alexduta192/Wearable-Sleep-Monitoring-System-/Duta_Alexandru-Vlad-ppt.v4.pptx

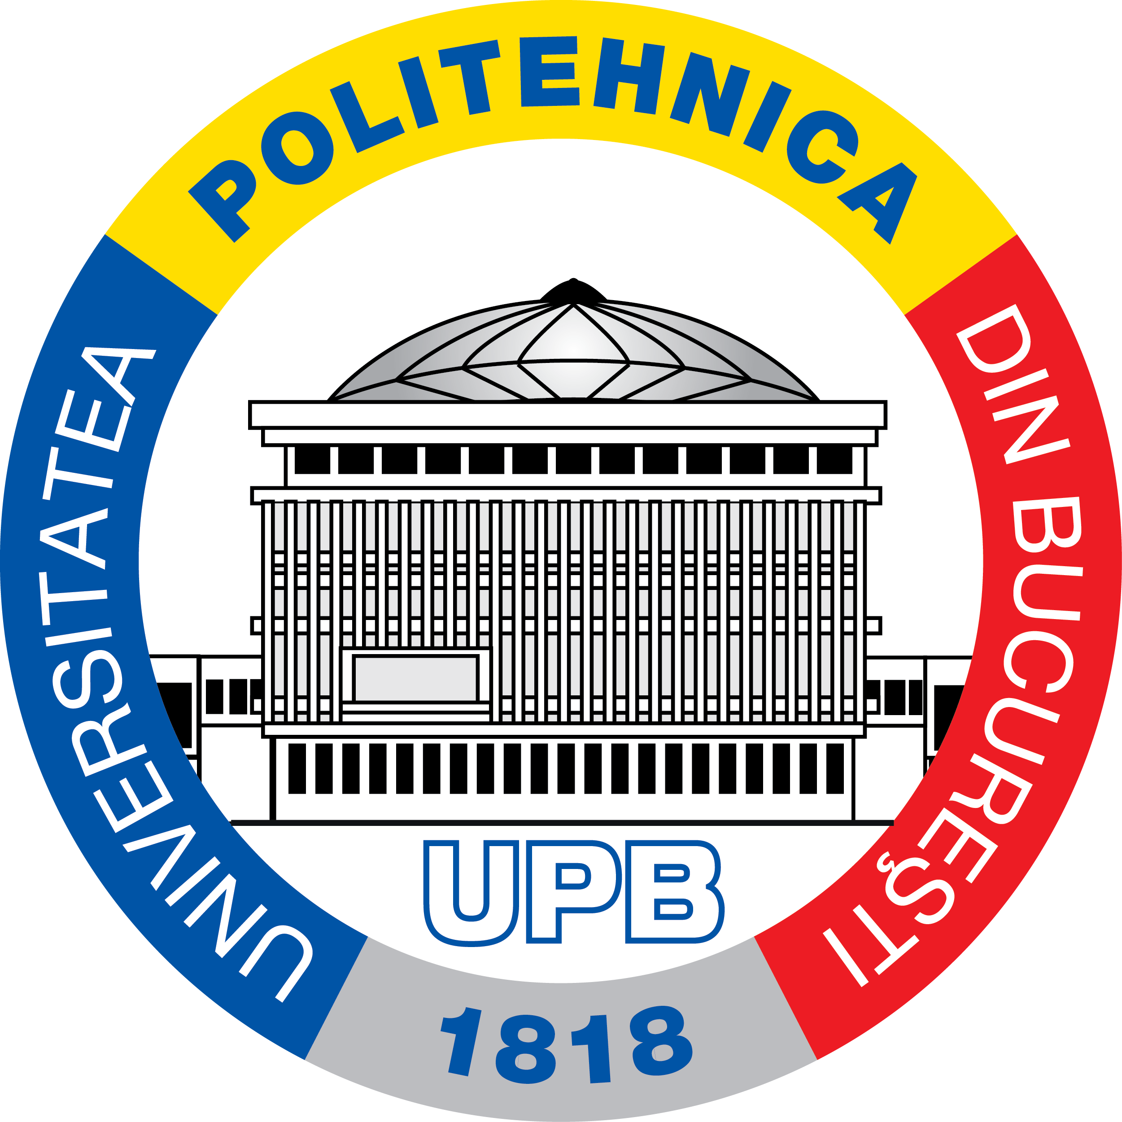
[picture p1: figure]
UPB Logo

NATIONAL UNIVERSITY OF SCIENCE AND TECHNOLOGY POLITEHNICA BUCHAREST

Developing a System for Physiological Signal Acquisition and Analysis for Sleep Quality Assessment

DIPLOMA PROJECT

GRADUATE

Duta Alexandru-Vlad

SCIENTIFIC COORDINATOR

Ph.D. Ovidiu Grigore

Faculty of Electronics, Telecommunications and Information Technology ·
2026

## Slide 2

00

Presentation Structure

Introduction to Sleep

Sleep stages, cycles, and why monitoring matters

1

Motivation

PSG vs commercial wearables vs this project

2

System Architecture & Hardware

ESP32-C3, sensors, wearable integration

Data Acquisition & Dashboard

Firmware, server, SQLite storage, live monitoring

3

4

Signal Processing & Features

Filtering, 21 features per 30-second window

5

Sleep Stage Classification

K-Means clustering, physiological rules, KNN

6

Results & Validation

10 sessions, hypnograms, quality scores

Conclusions & Future Work

Achievements, limitations, next steps

7

8

Overview

02 / 17

## Slide 3

01

Introduction to Sleep

Sleep occupies roughly one third of human life and is essential for physical recovery, memory consolidation, and emotional regulation. The AASM classifies sleep into four stages based on brain, muscle, and eye activity.

Light Transition

Theta waves replace alpha. Transition from wakefulness. Easy to wake.

→ System: Light Sleep

Not distinguished from N2 without EEG

Deep / SWS

Delta waves dominate. Lowest heart rate. Peak growth hormone and immune activity.

→ System: Deep Sleep

BPM≤P40 & motion≤P50, capped 25%

Rapid Eye Movement

Dreaming occurs. Muscle tone suppressed. Emotional and procedural memory processing.

→ System: REM Sleep

BPM≥P65 & std≥P55, capped 30%

N1

5–10%

Light Sleep

Sleep spindles and K-complexes. Heart rate falls. Memory consolidation begins.

→ System: Light Sleep

Not distinguished from N2 without EEG

N2

45–55%

N3

20–25%

REM

20–25%

This system outputs 4 classes — Wake/Movement, Light Sleep (N1+N2 combined), Deep Sleep, REM — since wrist sensors without EEG cannot separate N1 from N2.

A typical night contains 4–6 cycles of ~90 minutes each. N3 dominates early cycles; REM periods lengthen toward morning.

Introduction to Sleep

03 / 17

## Slide 4

02

Motivation

€600 – 2 000

per night

Clinical PSG

Gold standard but expensive, lab-bound, requires trained staff

65 – 75%

accuracy

Commercial Wearables

Affordable but black-box algorithms, no raw data access

Goal: build an open, low-cost wearable sleep monitoring system with full raw data access

<€100

OPEN-SOURCE

This Project

Full raw data access, 5 sensors + ML pipeline

Motivation

04 / 17

## Slide 5

03

System Architecture

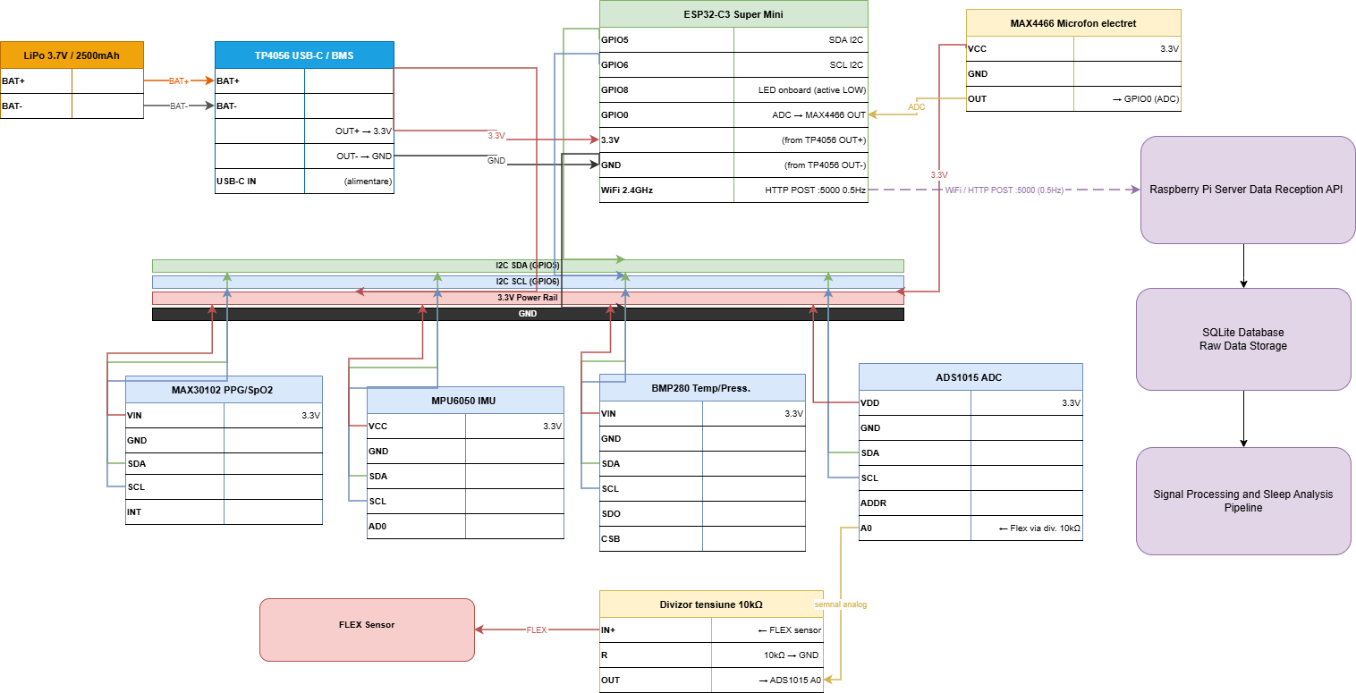
[picture p2: figure]

System Architecture & Hardware

05 / 17

## Slide 6

03

Hardware Design

ESP32-C3 Super Mini

RISC-V 160 MHz, WiFi, single-core

MCU

MAX30102

PPG + SpO₂ (red 660nm, IR 880nm)

Optical

MPU6050

6-axis IMU (accel + gyro)

Motion

BMP280

Skin temperature (±0.5°C)

Temperature

ADS1015 + Flex

Respiration via chest band

Respiration

MAX4466

Microphone for snoring detection

Acoustic

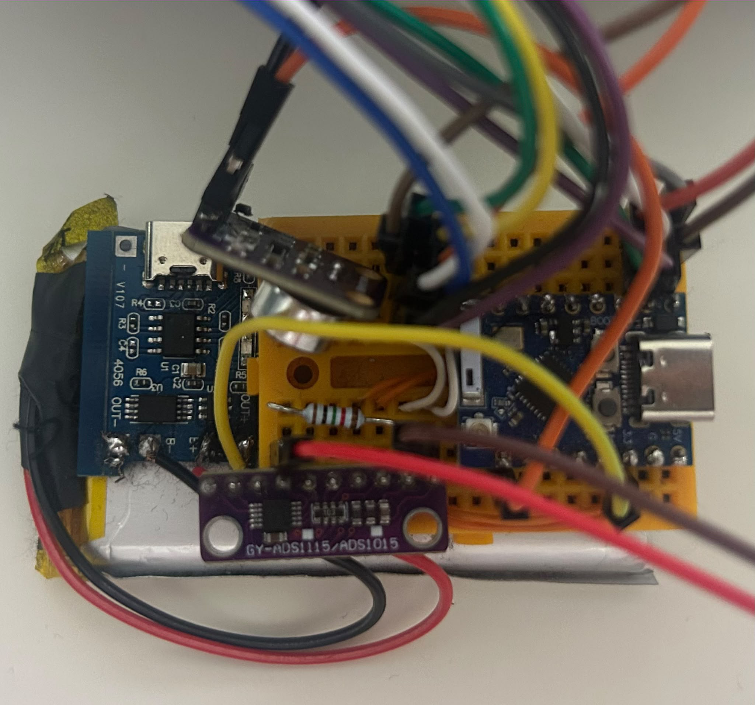
[picture p3: figure]

TP4056 + LiPo 2500 mAh · >17h runtime

System Architecture & Hardware

06 / 17

## Slide 7

03

Wearable Integration

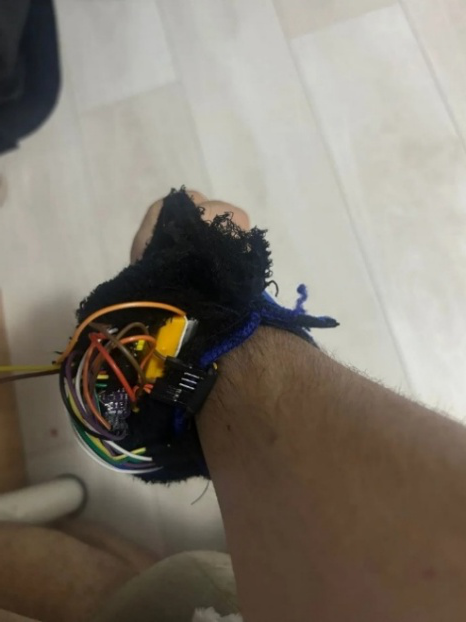
[picture p4: figure]
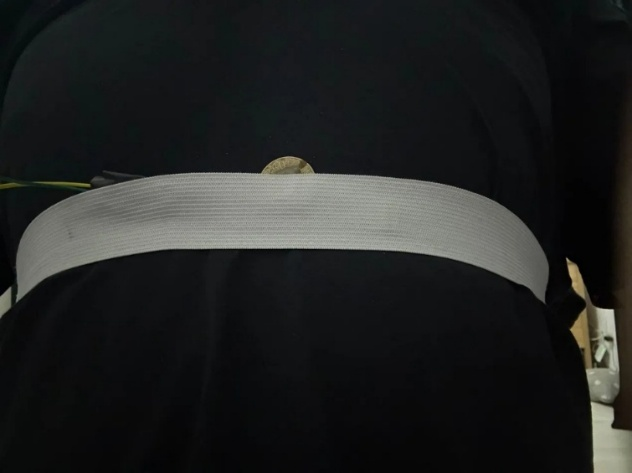
[picture p5: figure]

Wrist Unit

Elastic Chest Band

Flex sensor for respiration monitoring

PPG, IMU, temperature, microphone sensors during recording

System Architecture & Hardware

07 / 17

## Slide 8

04

Data Acquisition

Sensor Reading

PPG (IR+Red)

IMU (Acc+Gyro)

Flex (Resp.)

Temperature

Microphone

JSON Assembly

Single combined HTTP POST every 2s (single-core constraint)

{ "t":"23:35:01",
"ir":54231,
"red":48120,
"ax":0.01,
"ay":-0.99,"az":0.03,
"fr":612,"fd":-8,
"tmp":35.3,
"ppg_ir":"54231,...",
"mic_s":"1066,..." }

SQLite Storage

Raspberry Pi stores all raw data in structured tables

Analysis Pipeline

21 features/window. K-Means+KNN. Quality score.

Step A

Signal filtering
(sensor-specific)

Step B

Feature extraction
(21 features)

Step C

K-Means clustering
(k=4)

Step D

KNN + smoothing
+ scoring

1

2

3

4

12.5 Hz

10 Hz

raw_data

timestamp, JSON

4 Hz

→

→

ppg_data

IR, Red, BPM

→

1 Hz

flex_data

ADC, resp. rate

200 Hz

mic_data

RMS amplitude

WiFi

HTTP POST :5000
to Raspberry Pi

Key design decision: single combined POST per cycle avoids sample loss on single-core ESP32-C3

~227

Data Acquisition & Dashboard

samples/sec across
all sensors

2s

POST interval
single-core ESP32

6–10h

recording duration
per session

08 / 17

## Slide 9

04

Live Dashboard

Real-time signal monitoring on port 8080 during active recording sessions

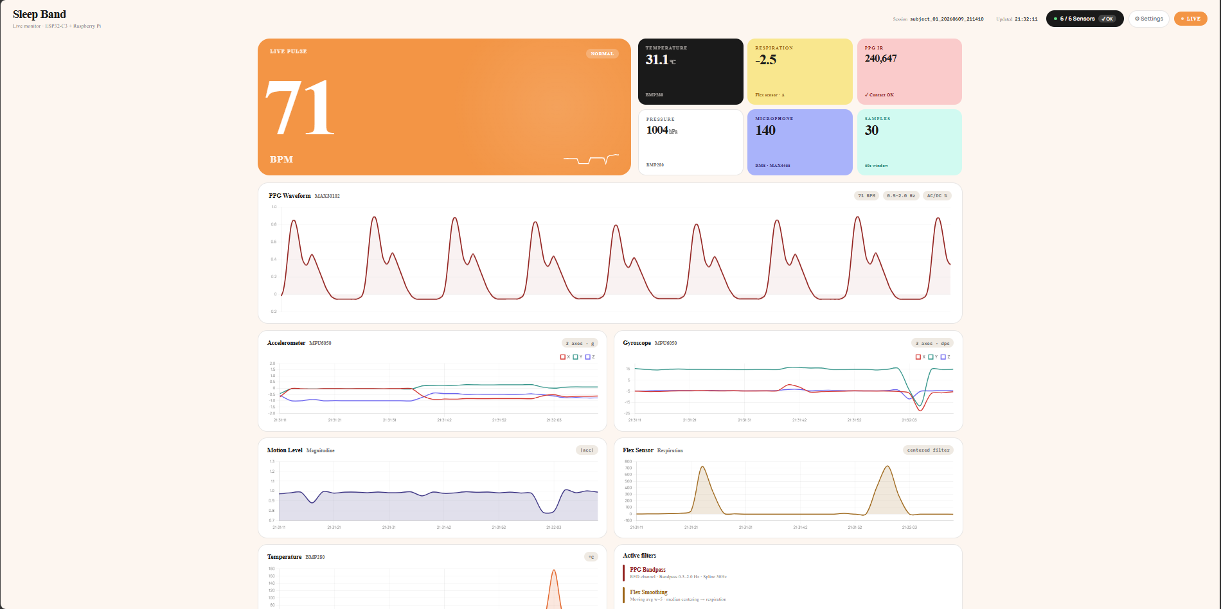
[picture p6: figure]

Data Acquisition & Dashboard

09 / 17

## Slide 10

05

PPG (IR)

Signal Processing

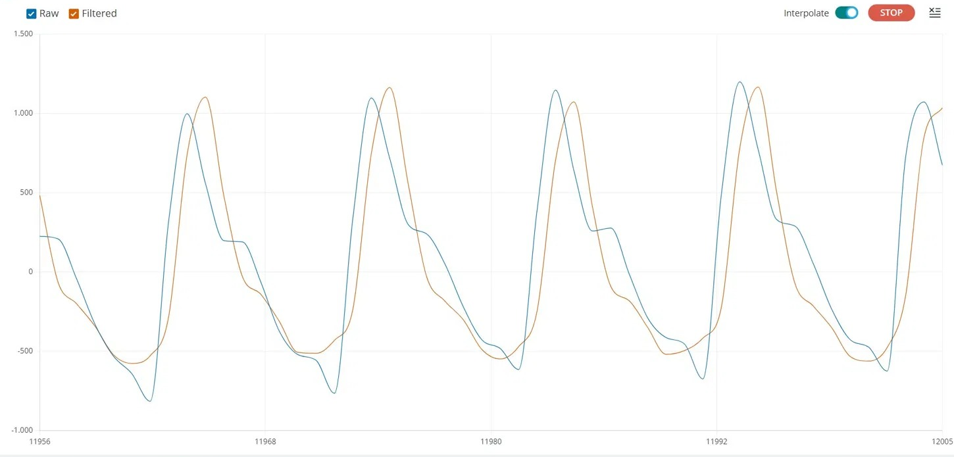
[picture p7: figure]

Butterworth 0.5–3.5 Hz, order 3

Gyroscope

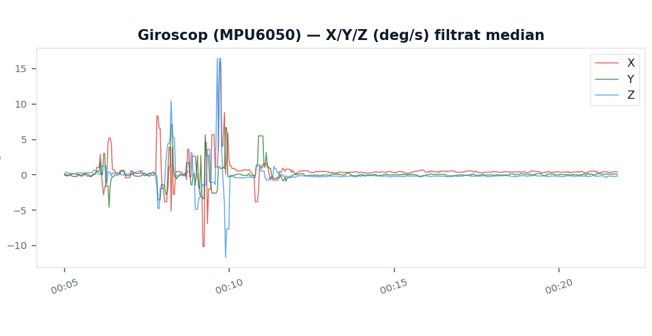
[picture p8: figure]

Median filter, kernel size 5

PPG chart

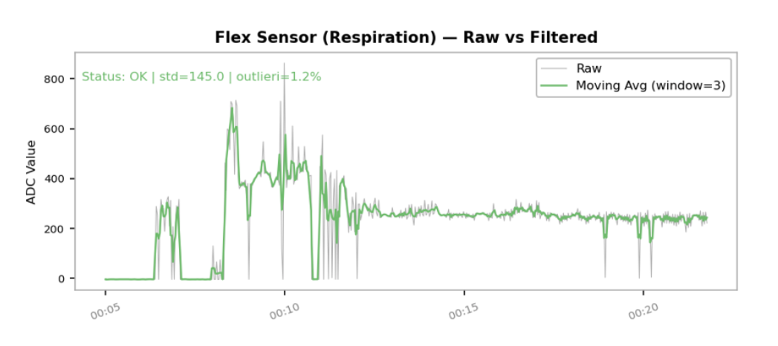
[picture p9: figure]

Flex Sensor

Moving average, window 3

Butterworth lowpass 0.1 Hz, order 3

Temperature

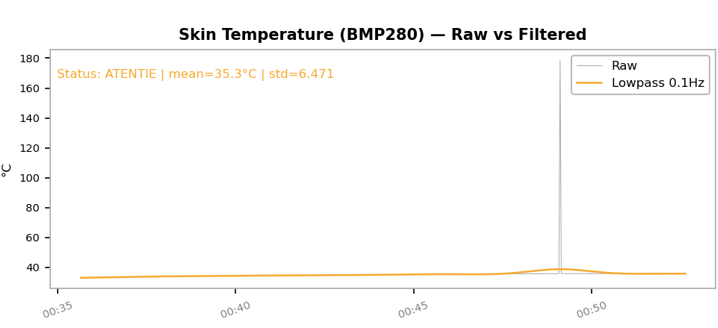
[picture p10: figure]

Signal Processing & Features

10 / 17

## Slide 11

Feature Extraction

21 features per 30-second window · StandardScaler · weighted by physiological relevance

05

PPG / Cardiac

×1.8

bpm_mean

×1.5

bpm_std

×1.0

bpm_min

×1.0

bpm_max

×1.6

hrv_simple

×1.2

spo2_est

Motion

×2.5

motion_level

×2.2

acc_jerk

×2.0

gyro_energy

×0.5

motion_variation

×1.0

dominant_pos

Respiration

×1.8

resp_rate

×1.4

resp_variability

×1.2

resp_amplitude

×1.0

apnea_flag

Temperature

×0.8

temp_mean

×0.5

temp_variation

Acoustic

score only

snore_events_count

score only

snore_intensity

Raw features → StandardScaler (zero mean, unit variance) → Multiply by weights → K-Means input.

Signal Processing & Features

Preprocessing Pipeline

contact_valid_ratio excluded (data leakage risk)

11 / 17

## Slide 12

06

Sleep Stage Classification

Physiological Labeling

Wake: motion ≥ P95

REM: bpm ≥ P65 AND bpm_std ≥ P55

Deep: bpm ≤ P40 AND motion ≤ P50

Light: all remaining windows

K-Means (k=4)

Unsupervised clustering into 4 groups.

Silhouette: k=2 best (0.797)
k=4 used for clinical relevance (0.290)

1

2

KNN (k=5)

Trained on K-Means labels. Distance-weighted Euclidean in 21D. Outputs per-class probabilities.

3

Smoothing

3-epoch majority vote (90s)

Deep cap: 25%, REM cap: 30%

4

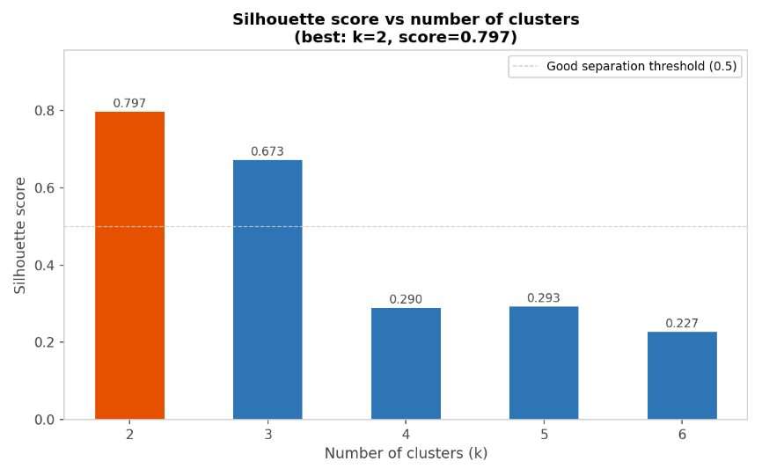
[picture p11: figure]
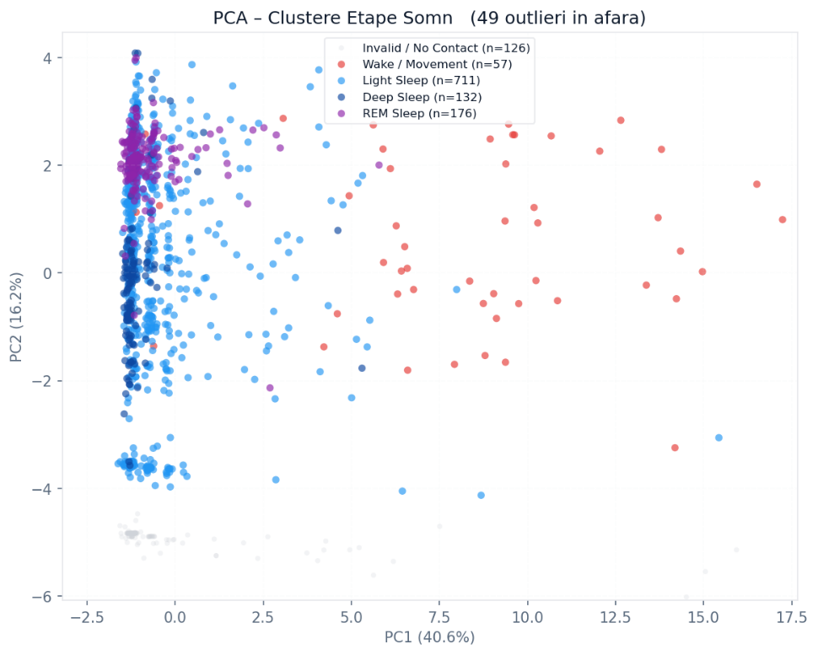
[picture p12: figure]

Sleep Stage Classification

12 / 17

## Slide 13

07

Results: Hypnogram Analysis

10 overnight sessions · 8 subjects · 375–602 min per session

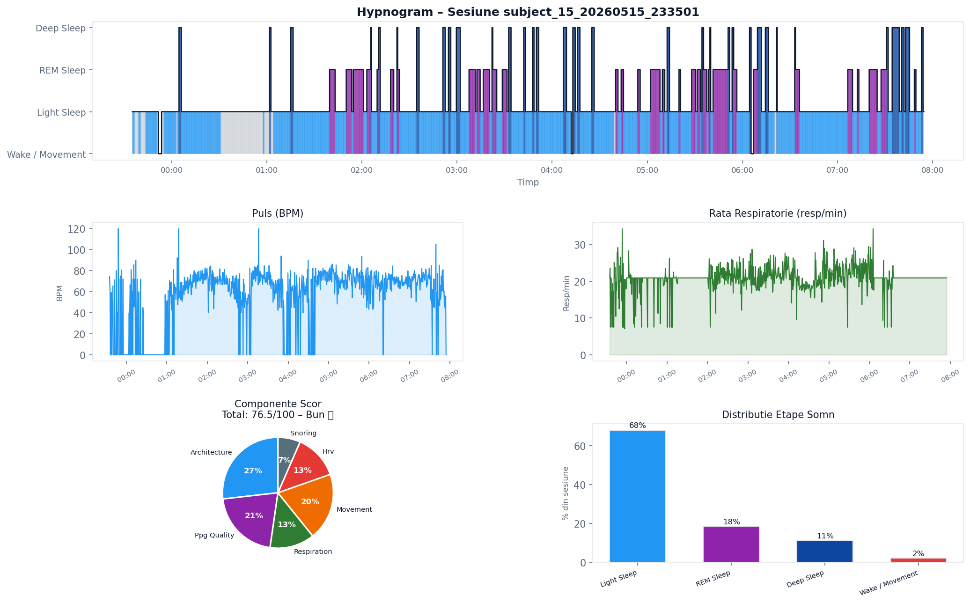
[picture p13: figure]

Results & Validation

13 / 17

## Slide 14

07

Sleep Quality Score

0–100 scale from 6 components · Duration penalty: up to −15 pts for sessions <6 hours

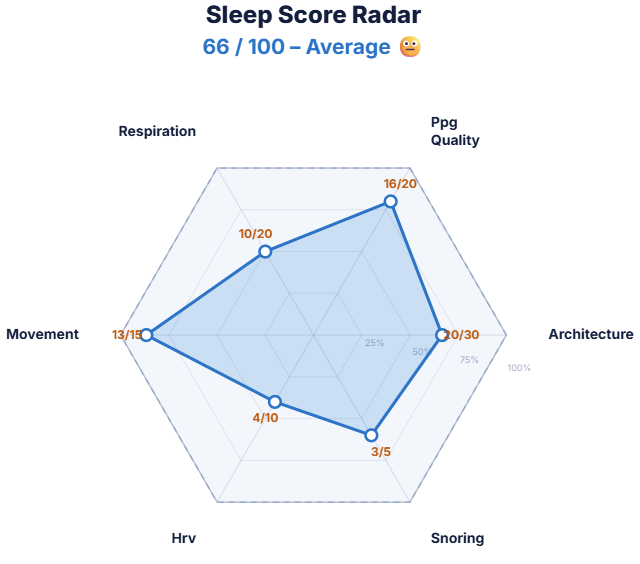
[picture p14: figure]

/30

Architecture

Deep ≥ 25%, REM ≥ 25%, Wake < 15%

/20

PPG Quality

BPM 45–70, SpO₂ ≥ 95%

/20

Respiration

RR 10–18, apnea < 2% of windows

/15

Movement

/10

HRV

Median motion < 0.05g

/5

Snoring

85–100 Excellent

70–84 Good

RMSSD 30–100 ms

0 events = full

55–69 Average

40–54 Poor

Results & Validation

14 / 17

## Slide 15

07

Subjective vs Objective Comparison

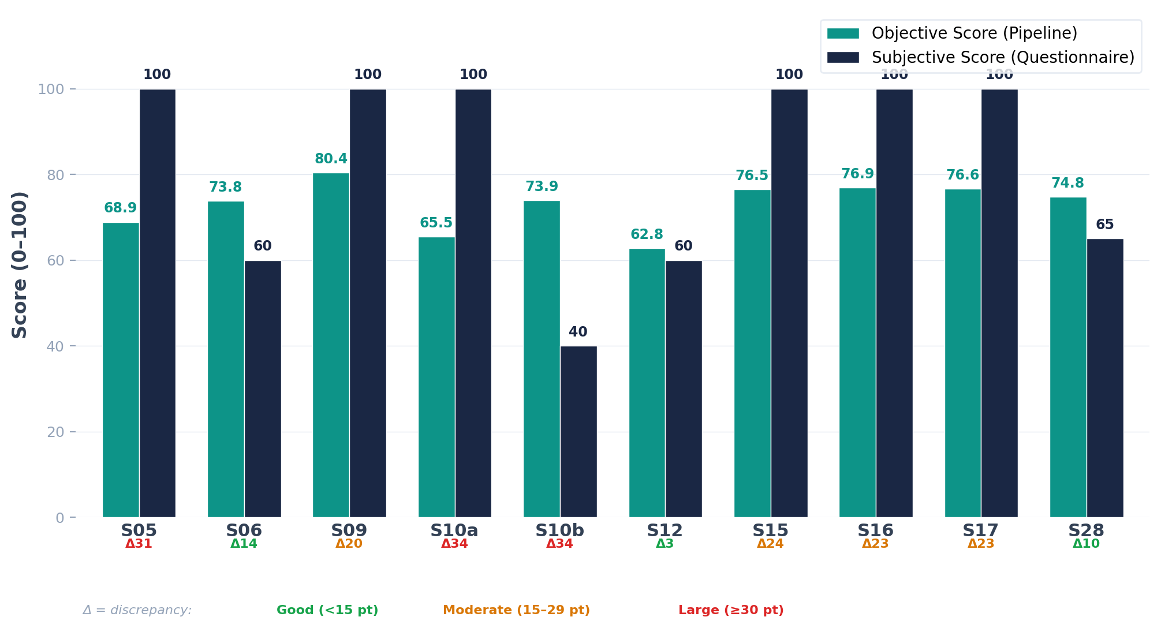
[picture p15: figure]

Results & Validation

15 / 17

## Slide 16

08

Key Findings & Limitations

Key Findings

Motion features: most reliable for sleep staging

→

Limitations

No ground truth (PSG) for epoch-level validation

—

HRV (RMSSD) + respiratory rate: strongest stage differentiation

→

Silhouette score k=4: 0.290 (overlap between stages)

—

S12 (OSA subject): 52 apnea + 257 snoring events correctly flagged

→

Single-core ESP32-C3 limits PPG to ~12.5 Hz effective

—

Subjects unaware of apnea events detected by sensors

→

Sensor displacement during sleep affects signal quality

—

Scores: 62.8 – 80.4 across valid sessions

→

Small sample: 10 sessions, 8 subjects

—

Personal contributions:
Complete hardware assembly from off-the-shelf components (<100 EUR)
ESP32-C3 firmware with multi-sensor acquisition and boot calibration
Flask/SQLite backend + real-time monitoring dashboard
Full Python pipeline: signal processing, 21-feature extraction, K-Means + KNN classification, sleep quality scoring
10 overnight recording sessions with 8 subjects + questionnaire validation

→

→

→

→

→

Key Findings & Limitations

16 / 17

## Slide 17

08

Conclusions & Future Work

The system demonstrates that open-source, low-cost sleep monitoring with full raw data access is achievable with current off-the-shelf components.

FUTURE WORK

Continuous 25 Hz PPG for frequency-domain HRV

01

Dual-core MCU

Custom 3D-printed enclosure for stable sensor contact

02

Rigid Housing

Inductive/impedance-based instead of flex sensor

Simultaneous recording for ground truth benchmarking

03

Better Respiratory Sensor

KNN evaluated on held-out data for real accuracy

04

Cross-session Training

05

PSG Validation

Thank you!

Conclusions & Future Work

17 / 17

## Slide 18

References

[3] R. B. Berry et al., "The AASM Manual for the Scoring of Sleep and Associated Events, Version 2.6," American Academy of Sleep Medicine, Darien, IL, 2020.
[1] R. Stickgold, "Sleep-dependent memory consolidation," Nature, vol. 437, pp. 1272-1278, 2005.
[11] M. de Zambotti, N. Cellini, A. Goldstone, I. M. Colrain, and F. C. Baker, "Wearable sleep technology in clinical and research settings," Med. Sci. Sports Exerc., vol. 51, pp. 1538-1557, 2019.
[14] M. Marino et al., "Measuring sleep: accuracy, sensitivity, and specificity of wrist actigraphy compared to polysomnography," Sleep, vol. 36, pp. 1747-1755, 2013.
[17] J. Allen, "Photoplethysmography and its application in clinical physiological measurement," Physiol. Meas., vol. 28, pp. R1-R39, 2007.
[19] Task Force of the European Society of Cardiology and the North American Society of Pacing and Electrophysiology, "Heart rate variability: standards of measurement, physiological interpretation and clinical use," Circulation, vol. 93, 1996.
